BeatriceAlbaWentworth/2026FPGA-40723/report/LLM辅助开发Skill记录表.xlsx

LLM辅助开发Skill记录表
日期 | 遇到的问题 | 如何寻求AI帮助（提问原话） | AI给的方案 | 如何处理AI的回答
2026.10.10 | FPGA项目中软硬件任务边界不清晰，难以判断哪些功能真正由开发板完成。 | 根据项目实际功能，帮我梳理PC端与FPGA端的数据处理流程，并核对目前的硬件验证情况。 | 梳理PC数据发送、FPGA串口接收、FIR滤波、FFT变换、频谱回传及PC端后处理的完整链路。 | 对照开发板实物、烧录文件、引脚约束和串口测试记录逐项核实，区分模拟数据输入与真实硬件处理，避免夸大项目完成情况。
2026.10.18 | Python程序出现数组只读错误、文件路径错误，影响批量数据处理。 | 根据报错信息和现有项目目录，分析问题原因，尽量少修改原有代码和程序逻辑。 | 根据Traceback定位错误位置，检查数组属性和文件实际存储层级，提出针对性修改。 | 结合终端报错和文件目录逐步排查，只修改必要部分；每次修改后重新运行程序，确认问题是否真正解决
2026.10.24 | FFT 输出位宽按 16 位/分量设计，1024 点未缩放时峰值模长会超出 int16 范围 | 帮我把 FIR+FFT 数据通路配好，输入是 1024 点 int16、幅值 9000 的正弦 | 给出 FIR（65 抽头 Q15）和 FFT（1024 点、Unscaled、自然序）的配置方案，输出按 16 位/分量 | 没有直接采用。按 N×A/2 手算峰值模长约 4.6×10⁶，远超 int16 上限 32767（差 141 倍）；改为 32 位槽位、27 位有效输出，并把位宽预算公式写进设计文档
2026.10.24 | FIR Compiler 未配置 TLAST，帧边界不向下游传递，FFT 无法识别一帧结束 | FIR Compiler 的接口选项怎么配 | 重点给了系数、位宽和采样率，未提及 TLAST 设置 | 查 IP 手册后确认 TLAST 必须选 Packet Framing。若保持默认，FFT 永远不输出结果且不报任何错误，属于静默失败，已记入设计检查清单
2026.10.25 | FPGA返回的频谱数据较多，需要从频域数据中提取有效特征并完成故障分类。 | 我的batch_features.py需要读取FPGA返回的30份频谱文件，提取特征并用于后续分类，应该如何实现？ | 建议统一读取频谱CSV，提取主频、RMS、二次和三次谐波等特征，再通过分类程序进行训练和测试。 | 根据实际CSV列名和数据结构调整代码，检查30份数据的完整性，并通过特征统计表、混淆矩阵和评价指标验证结果
2026.10.25 | 仿真中 1024 个样本全部正确、校验和通过，但 tlast 始终不拉高，帧无法结束 | 为什么样本都对、校验也对，tlast 却一直不出现 | 怀疑帧格式长度或计数器位宽有问题，建议检查 frame_rx 的状态机 | 逐信号追波形后定位：非阻塞赋值导致判断用了旧计数值，样本计满条件写成 2046，实际应为 2047。改为 2047 后仿真 15 秒即通过，避免了上板后无输出且无法排查的困境
2026.10.26 | 硬件返回的 peak_mag 与 Python 模型对不上（差约 30%），但峰值频点定位一致 | 频谱峰值频点一致，为什么幅值对不上 | 建议上位机也改用 |I|+|Q| 同一种度量去比 | 分析后发现 |I|+|Q| 是相位相关的近似（最大偏差 41%），而硬件与模型的 I/Q 存在相位旋转，该度量天然不可比。验证统一改用 √(I²+Q²)，逐点误差降到 0.007%，并在协议文档中明确 peak_mag 只能作相对指标
2026.10.30 | 板载 CH340 串口接在 PS 的 MIO14/MIO15，纯 PL 设计收不到数据，端到端无法联调 | 板子自带的 USB 串口能不能直接给 PL 用，还有没有别的通道 | 先推测 FT2232 的第二通道可能可用，后又推测 COM7 可直连 PL | 两条推测都没有采信，改用实测验证：往 COM7 发 2 帧真数据，板载 LED 不亮，坐实不通。再查原理图确认 MIO14/15 为 PS 专用，最终外接 USB-TTL 模块接到 J8 排针的 U7/V7，联调一次通过
2026.10.31 | FPGA与Python的性能测试涉及不同计时范围，难以直接比较。 | 如何区分FPGA内部计算时间、串口传输时间和PC端到端延迟？怎样才能保证性能对比具有合理性？ | 区分FPGA流水线排空时间、串口通信时间和PC端到端耗时，分别统计不同指标。 | 重新核对计数器定义、测试日志和原始数据，不直接将不同测量边界的时间进行比较，避免得出不严谨的加速结论。
