BeatriceAlbaWentworth/2026FPGA-40723/report/figures/任务03_RTL模块层级图.png

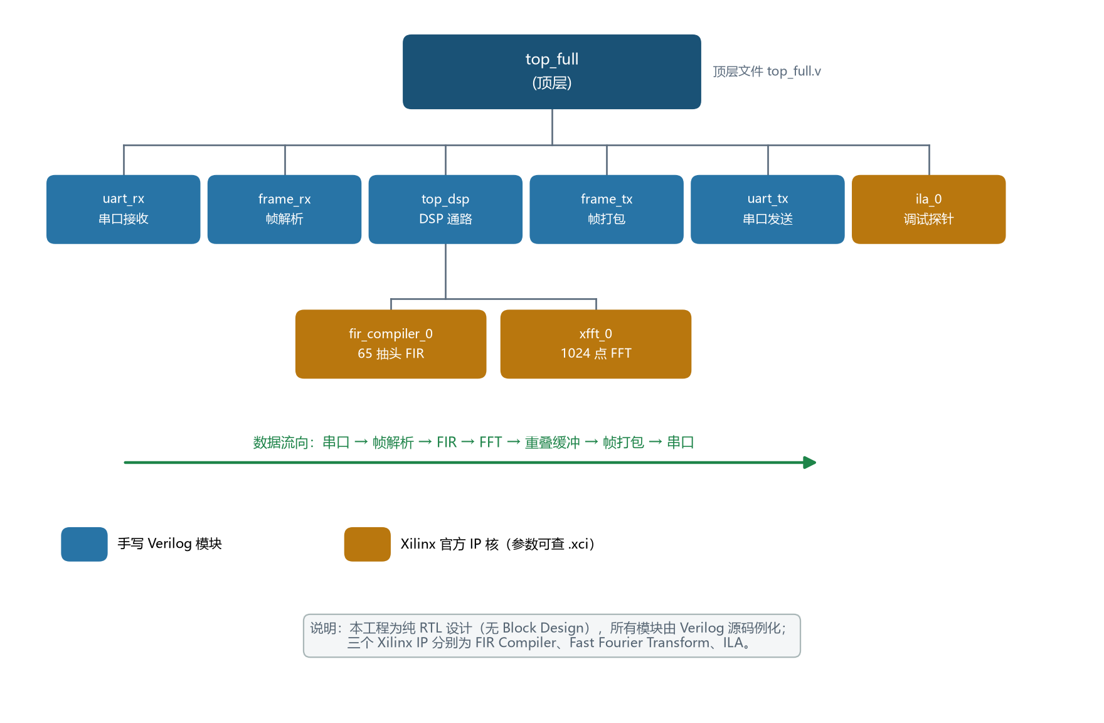
report/figures/任务03_RTL模块层级图.png
