BeatriceAlbaWentworth/2026FPGA-40723/report/figures/任务03b_XDC引脚与时序约束.png

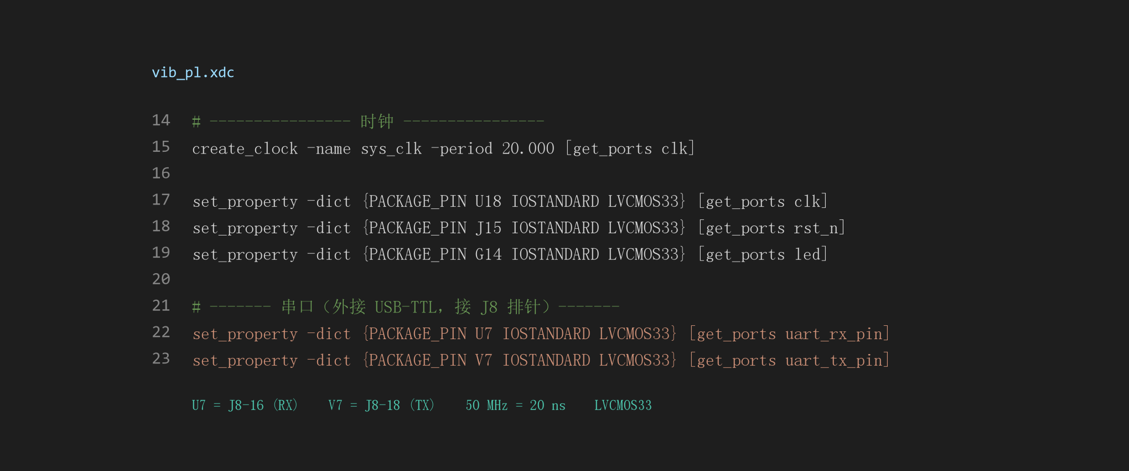
report/figures/任务03b_XDC引脚与时序约束.png
