BeatriceAlbaWentworth/2026FPGA-40723/report/figures/任务06b_混淆矩阵.png

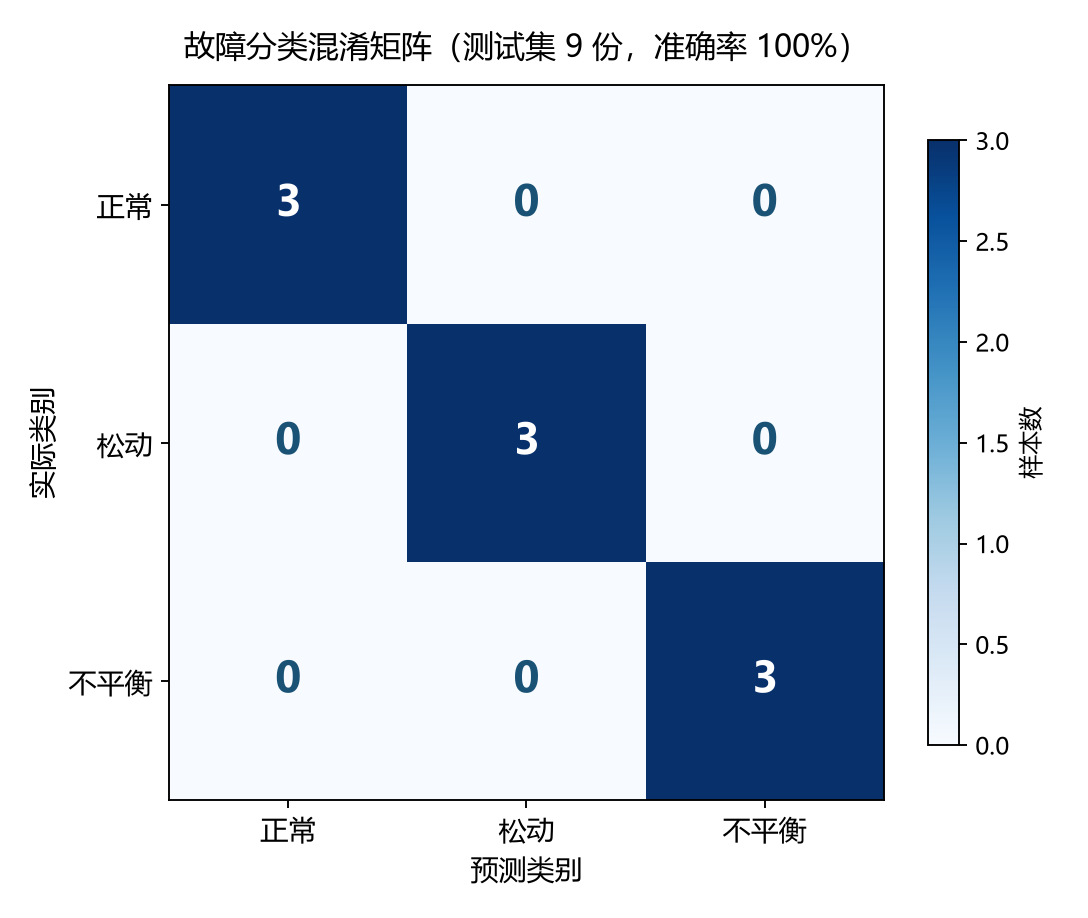
report/figures/任务06b_混淆矩阵.png
