BeatriceAlbaWentworth/2026FPGA-40723/report/figures/任务07-2_FIR通道规格_50MHz.png

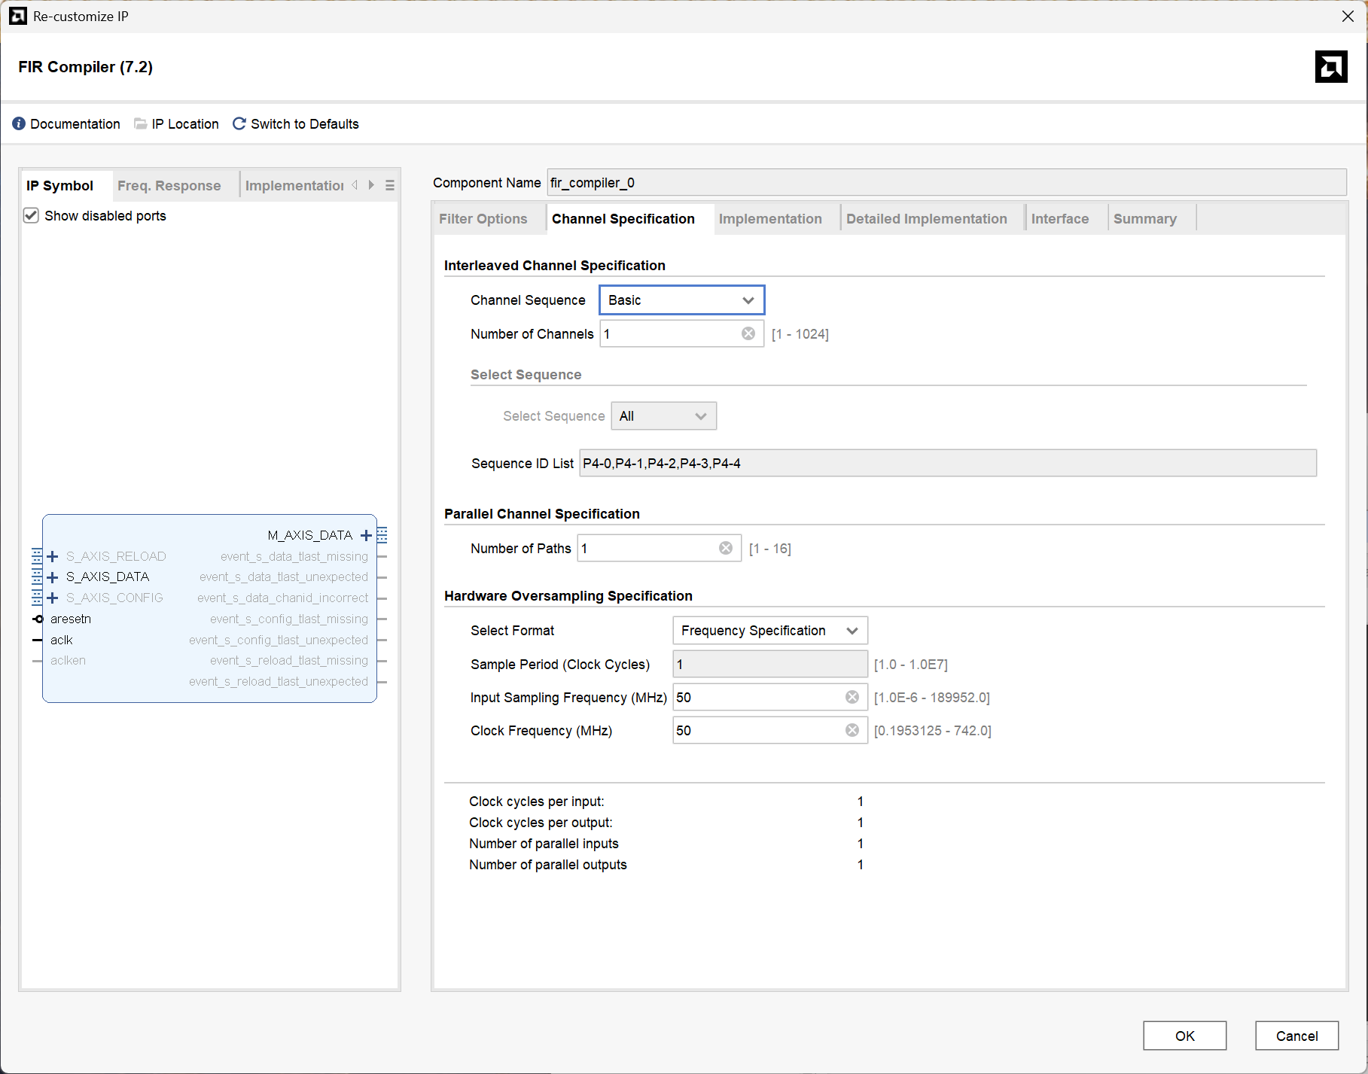
report/figures/任务07-2_FIR通道规格_50MHz.png
