BeatriceAlbaWentworth/2026FPGA-40723/report/figures/任务07-3_FFT配置_1024点.png

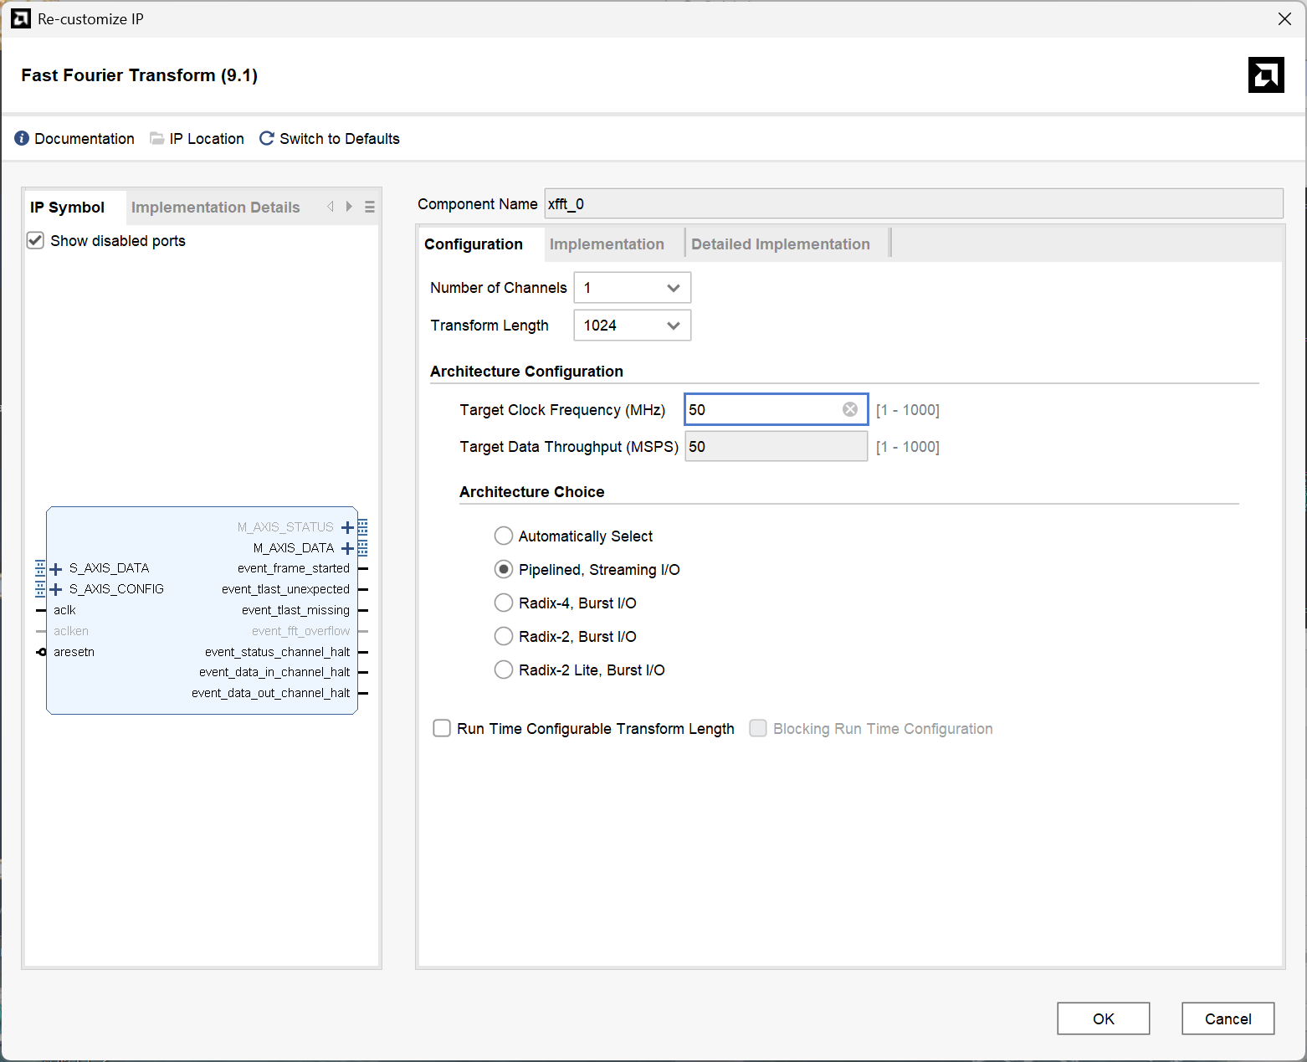
report/figures/任务07-3_FFT配置_1024点.png
