BeatriceAlbaWentworth/2026FPGA-40723/report/figures/任务11-1_滤波前后时域对比.png

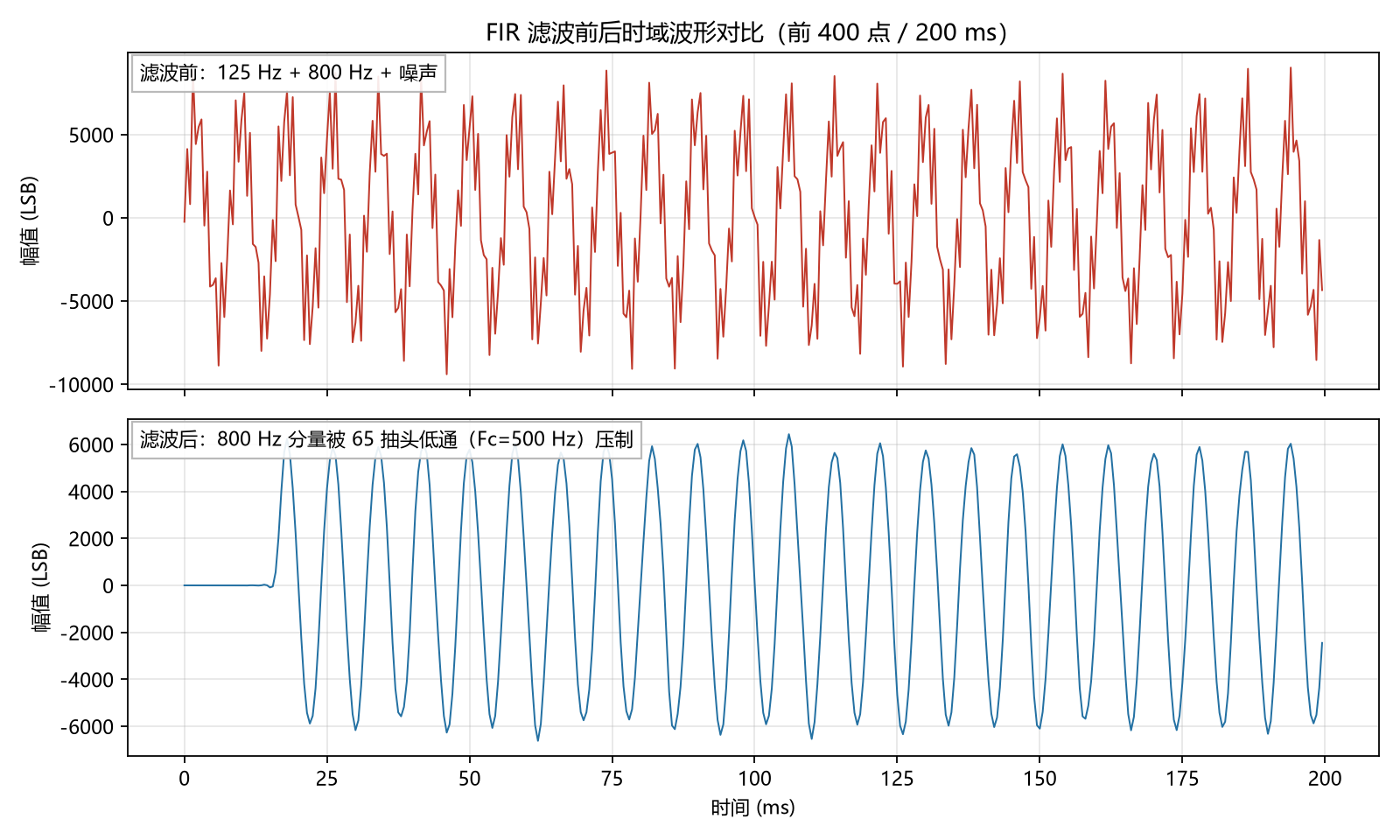
report/figures/任务11-1_滤波前后时域对比.png
