BeatriceAlbaWentworth/2026FPGA-40723/board/test_results/ILA波形截图.png

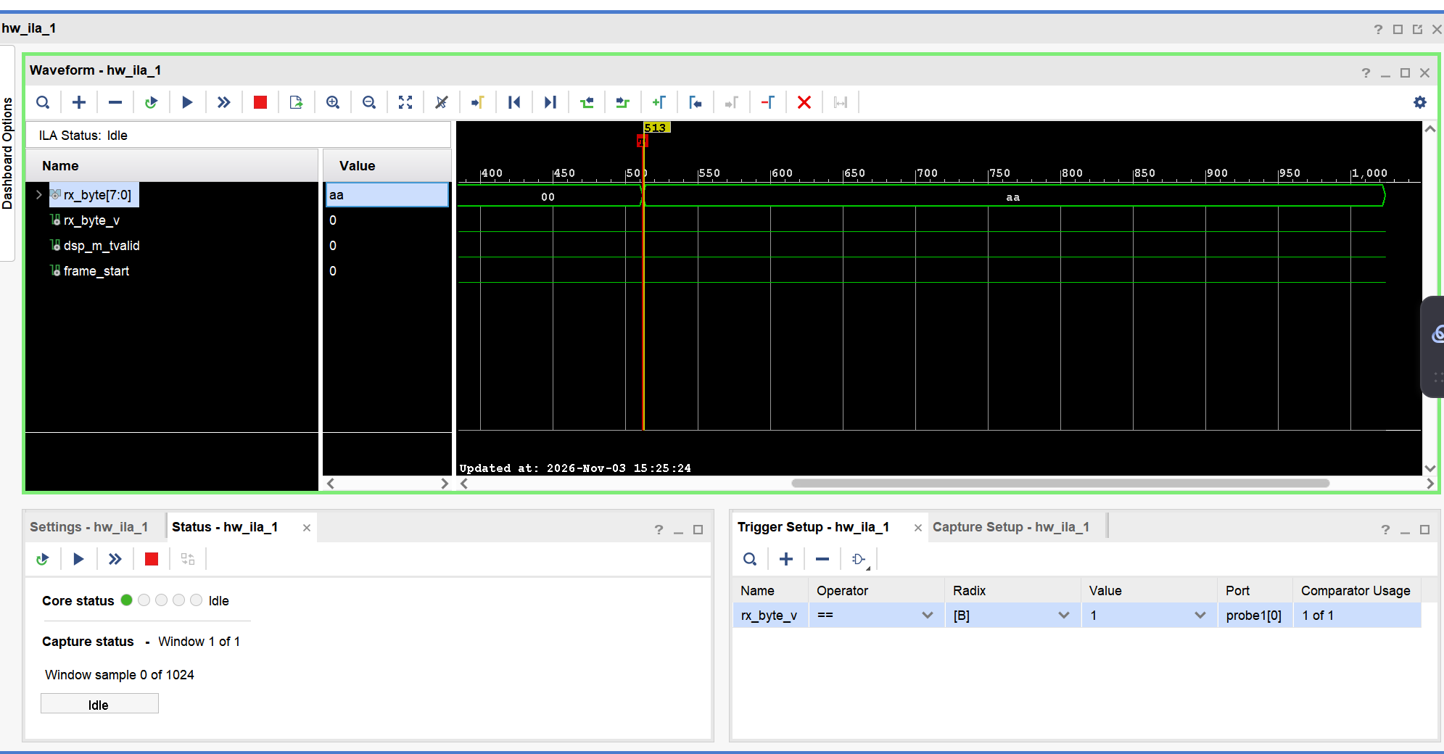
board/test_results/ILA波形截图.png
