BeatriceAlbaWentworth/2026FPGA-40723/board/test_results/三状态频谱.png

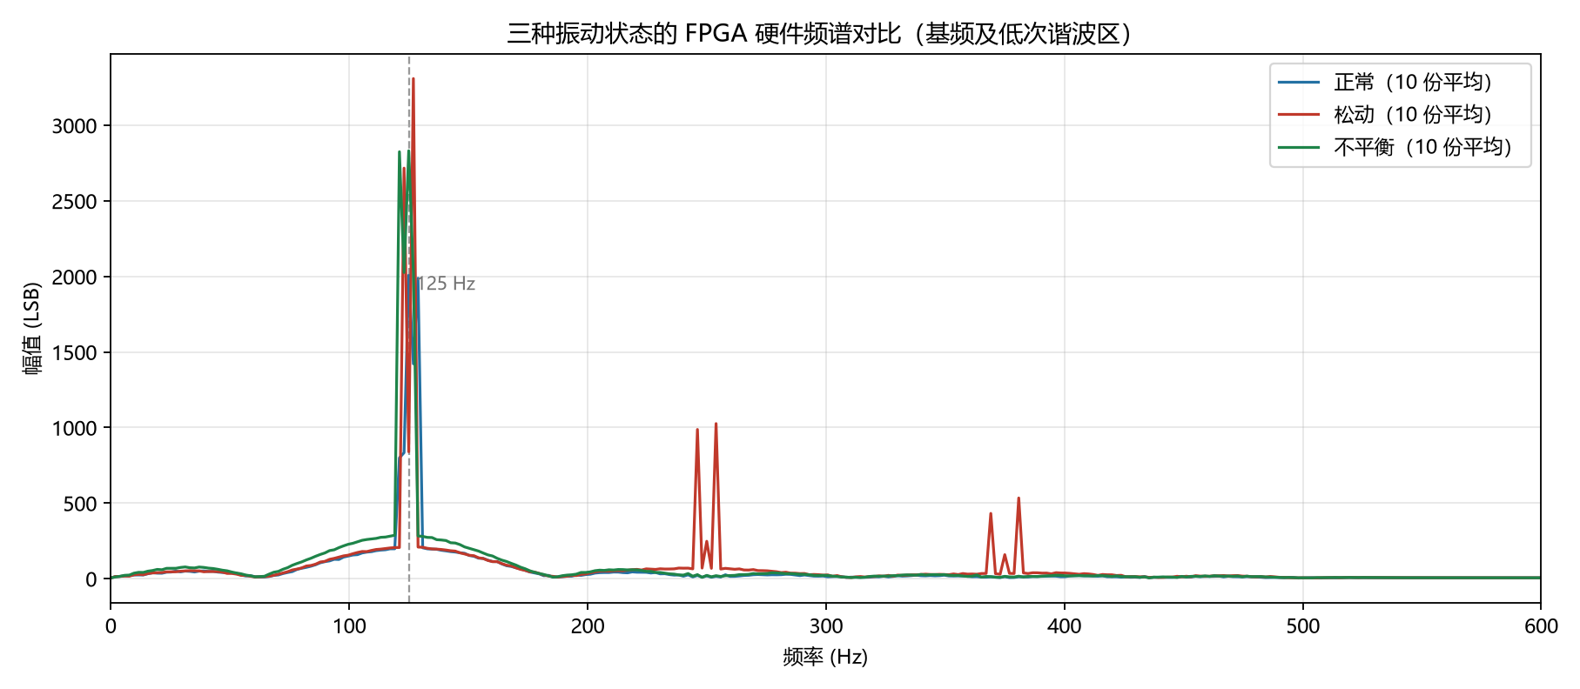
board/test_results/三状态频谱.png
