BeatriceAlbaWentworth/2026FPGA-40723/board/test_results/时序收敛.png

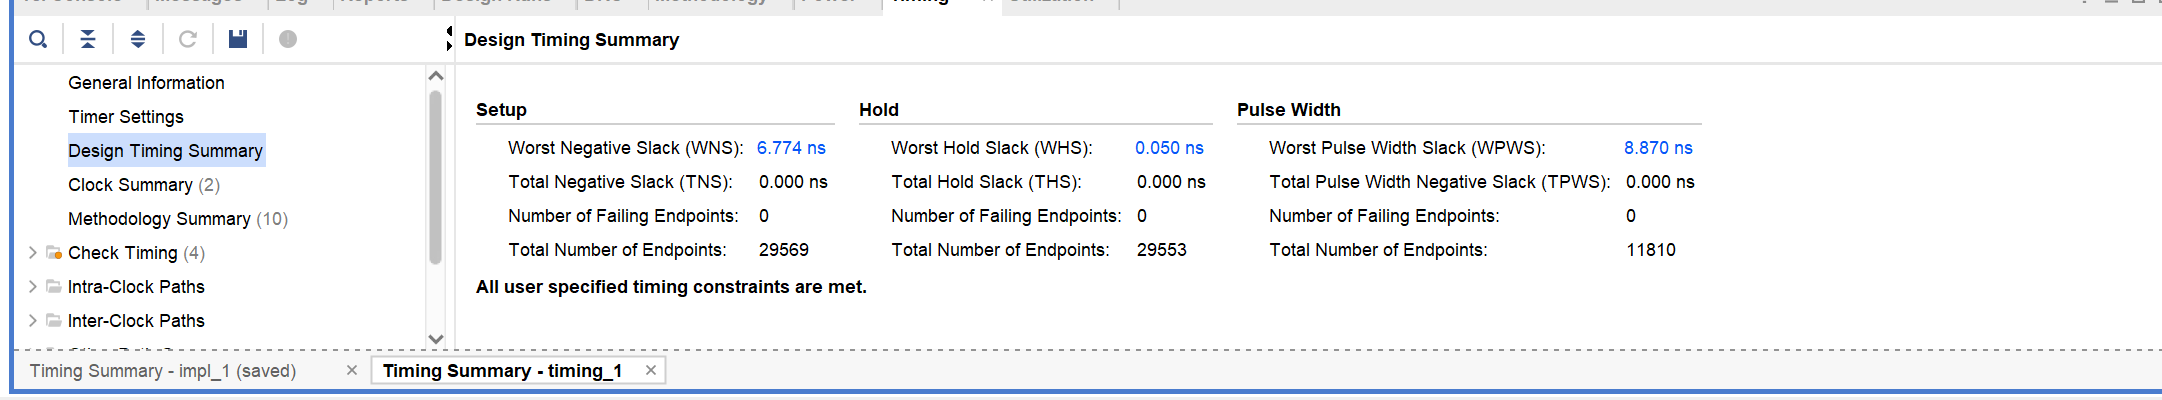
board/test_results/时序收敛.png
